ChiragKotian/Industrial_Monitoring-Control_System/LMP/V1/LMP_code/AHT20_driver.h

#ifndef AHT20_driver_H
#define AHT20_driver_H

#include <Arduino.h>

class AHT20_sens
 {
public:
    static bool initAHT();
    static void readAHT(float& tempOut, float& humOut, bool& faultOut);
};

#endif
