ChiragKotian/Industrial_Monitoring-Control_System/Node/V1/Node_Main/Node_Storage.h

#ifndef NODE_STORAGE_H
#define NODE_STORAGE_H

#include "Node_Config.h"
#include <SD.h>

#define MAX_LOG_LENGTH 128

struct StorageLogPacket {
    char dataRow[MAX_LOG_LENGTH]; 
};

class NodeStorage {
public:
    static void init();
    static void logStringPacket(const String& csvRow);
    static void runStorageWorker(void* pvParameters);
    
    static bool sdAvailable;
    static bool isSystemReady;
    static QueueHandle_t xStorageQueueHandle;

private:
    static bool switchToSD(); // 🔄 The Resync-on-Switch Helper
};

#endif
