ChiragKotian/Industrial_Monitoring-Control_System/(commit log)

2026-05-24 Bring repo upto current work
2026-06-06 Squashed bugs and the test code works
    [Node_CAN.cpp, Node_CAN.h, Node_Config.h, Node_Main.ino, Node_Registry.cpp, Node_Registry.h, Node_Storage.cpp, Node_Storage.h]
2026-06-08 csv updates🥲
2026-06-17 integrations work but has some issues like no discovery waiting
    [AHT20_driver.cpp, LMP_Hardware.cpp, LMP_code.ino, LMP_hardware.h, MLX_driver.cpp, Node_CAN.cpp, Node_Main.ino, Node_Storage.cpp]
2026-06-19 error byte in lmp
    [LMP_Hardware.cpp, LMP_hardware.h]
2026-06-19 implemented proper ui pages, proper discovery waits and error byte showing live lmp error stat
    [LMP_code.ino, Node_CAN.cpp, Node_CAN.h, Node_UI.cpp, Node_UI.h]
2026-06-20 partial implementation of buttons
2026-07-05 lora aes encryption, sd card and can on same spi, sd card data upload batch wise
2026-07-12 added reason for using arduino nano in readme
2026-07-12 added a flowchart showing rtos working
2026-07-12 edits to rtos working flowchart
2026-07-16 made dashboard for graphs of data, uses csv to load data
    [live_database.csv]
2026-07-16 added few features to dashboard like, moving window for graphs, sd card data merged or standalone, alarm threshold changeable
    [sd_database.csv]
2026-07-16 Revert "added few features to dashboard like, moving window for graphs, sd card data merged or standalone, alarm threshold changeable"
    This reverts commit 692e1e7e8ccdfbcab2b7a63f2ea1577be1377446.
    [sd_database.csv]
2026-07-18 updated features in dashboard
    [live_database.csv, sd_database.csv]
